Airrr17/AirrrBOT/PICS/model.png

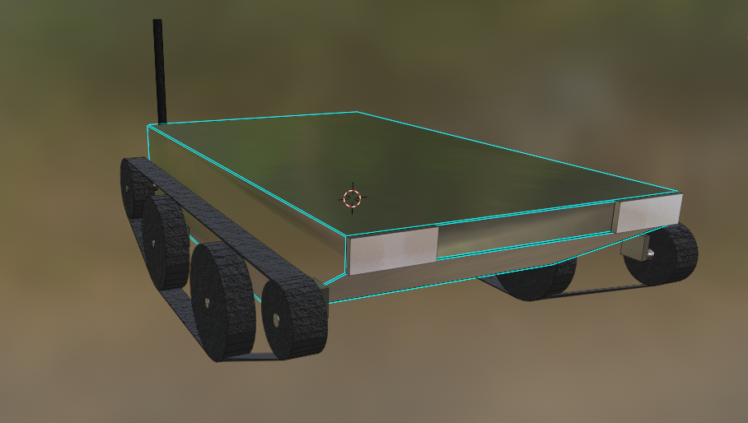
PICS/model.png
