Airrr17/AirrrBOT/3Dmodel/robot.obj

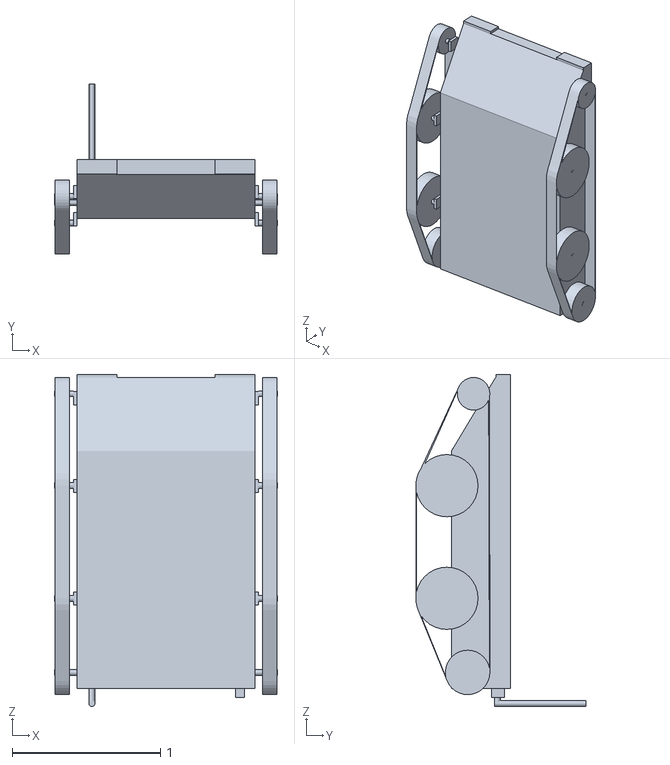
[picture p6: CAD file, 2024-10-28]
3Dmodel/robot.obj
1.50 x 1.15 x 2.24
