Airrr17/AirrrBOT/(commit log)

2019-12-21 Update
    Current sensing while hatch in actions.
    Total robot's current sensor.
    Abort if auto-rotation fails.
2019-12-21 Block circuit added
2020-06-16 XL320 readings
    Servo position reading implemented.
2024-10-28 major update
    inc. control software.
    [robot.obj]
